holalluis/lora-waspmote/felix-llegir-sensors-2019/README.txt

Com programar la placa

Pels sensors DS18B20 Anar a File, Examples, General, Basic Sensors,
BS_05_Reading_temp_DS18B20

Com rebre dades de la placa al PC: Amb la funció USB.print que veuràs als
exemples podràs enviar dades al PC per depurar el codi.  IMPORTANT: quan obris
la terminal del Arduino que s’han clonat, el Waspmote, veuràs que pots triar la
velocitat del port. Has de triar la velocitat de 115200 bauds.
