holalluis/lora-waspmote/guia-instal.lacio.md

# GUIA INSTAL·LACIÓ
*Ordinador*
1. Connectar MÓDEM USB internet
2. Connectar Gateway 
3. Obrir waspmote
4. Comprovar que s'envien dades

*Prototip*
1. Comprovar connexions

         i. Cables
  
        ii. Soldadures
  
       iii. Plaques connectades
  
        iv. Bateria
  
2. Segellar caixa amb sica o silicona
3. Desplegar cables de tots els sensors
4. Instal·lar caixa, amb cinta perforada galvanitzada

*Sensors*
1. Mirar núm de sensor de temperatura i localització (A,S,D)
2. Instal·lar sensors de temperatura
3. Instal·lar sensor maxbotix
4. Mirar alçada làmina d'aigua Maxbotix
5. Instal·lar capacitiu
