holalluis/lora-waspmote/docs/Protocol de carrega de la bateria.pdf

### Protocol de càrrega de la bacteria del Waspmote

1. Endollar la bateria al connector que s’indica.

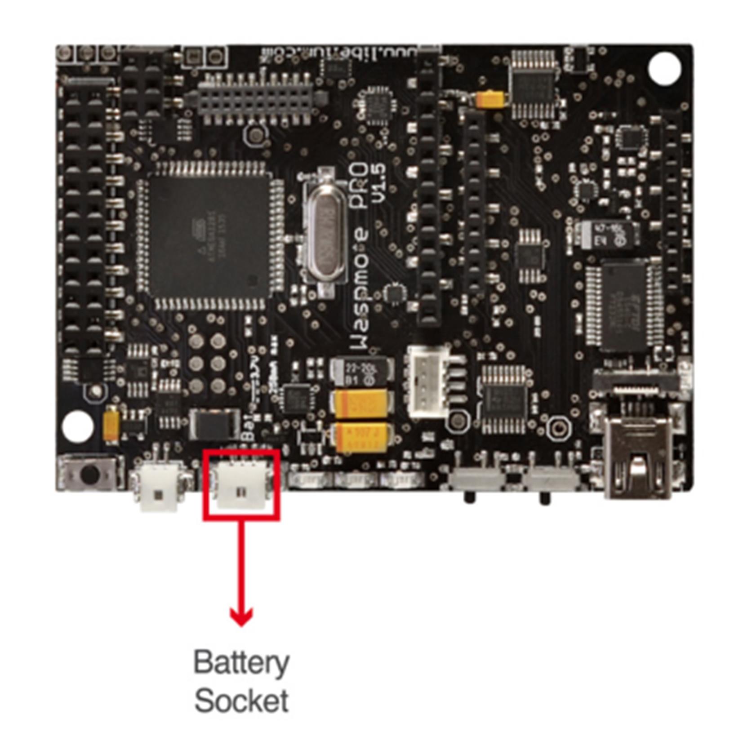
[picture p1: figure]

2. Endollar el cable miniusb a una font d’alimentació. Es recomana que sigui un portàtil o un carregador de mòbil.

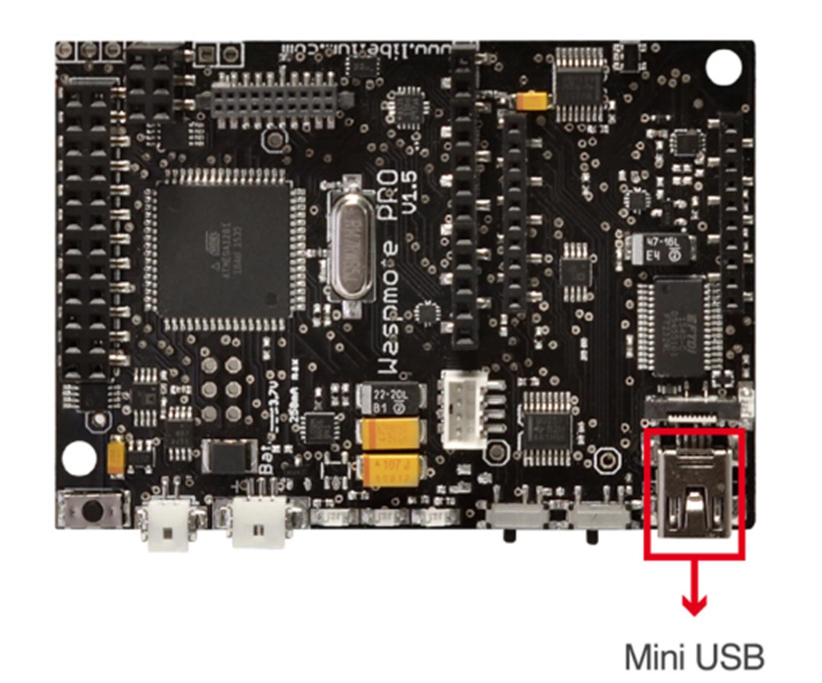
[picture p2: figure]
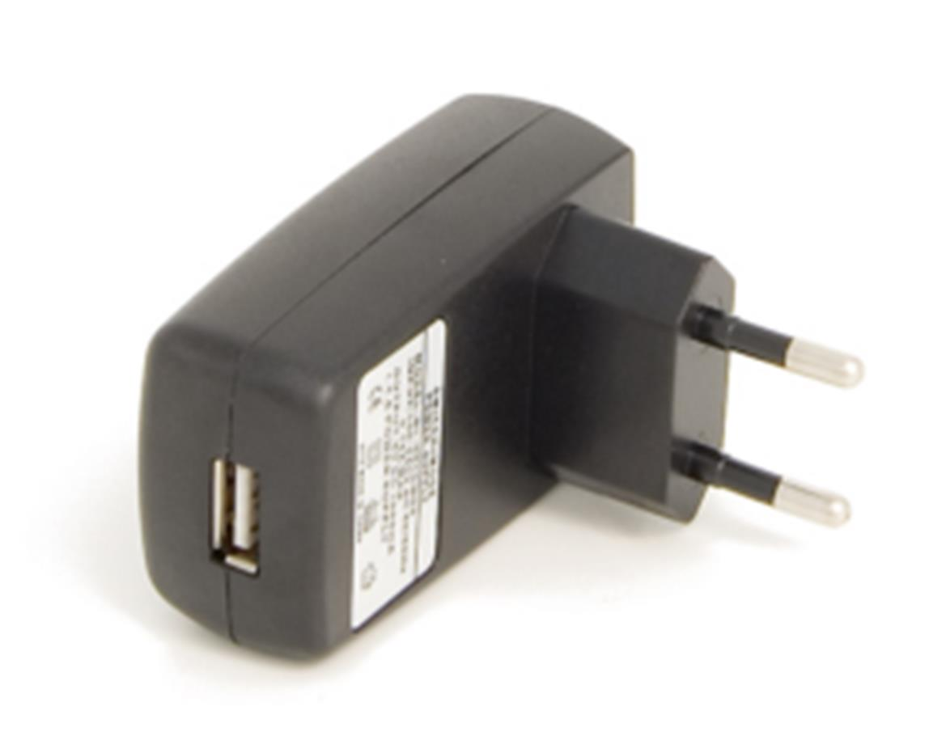
[picture p3: figure]

### 3. Quan la bateria s’estigui carregant s’engegarà el batery LED:

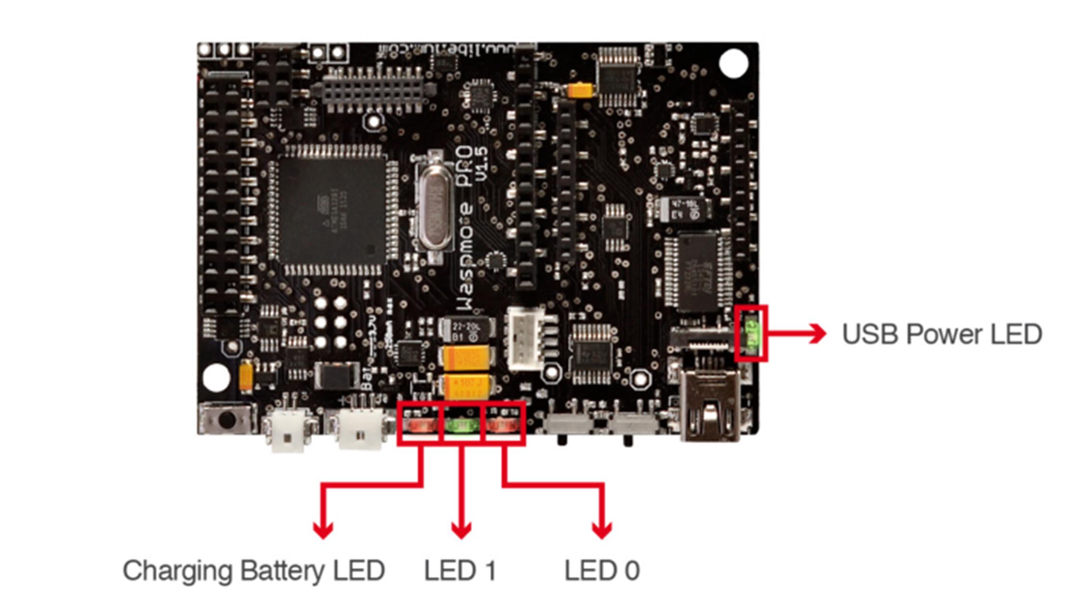
[picture p4: figure]

Un cop la bateria estigui completament carregada, el battery LED s’apagarà.
