holalluis/lora-waspmote/docs/waspmote_pins.png

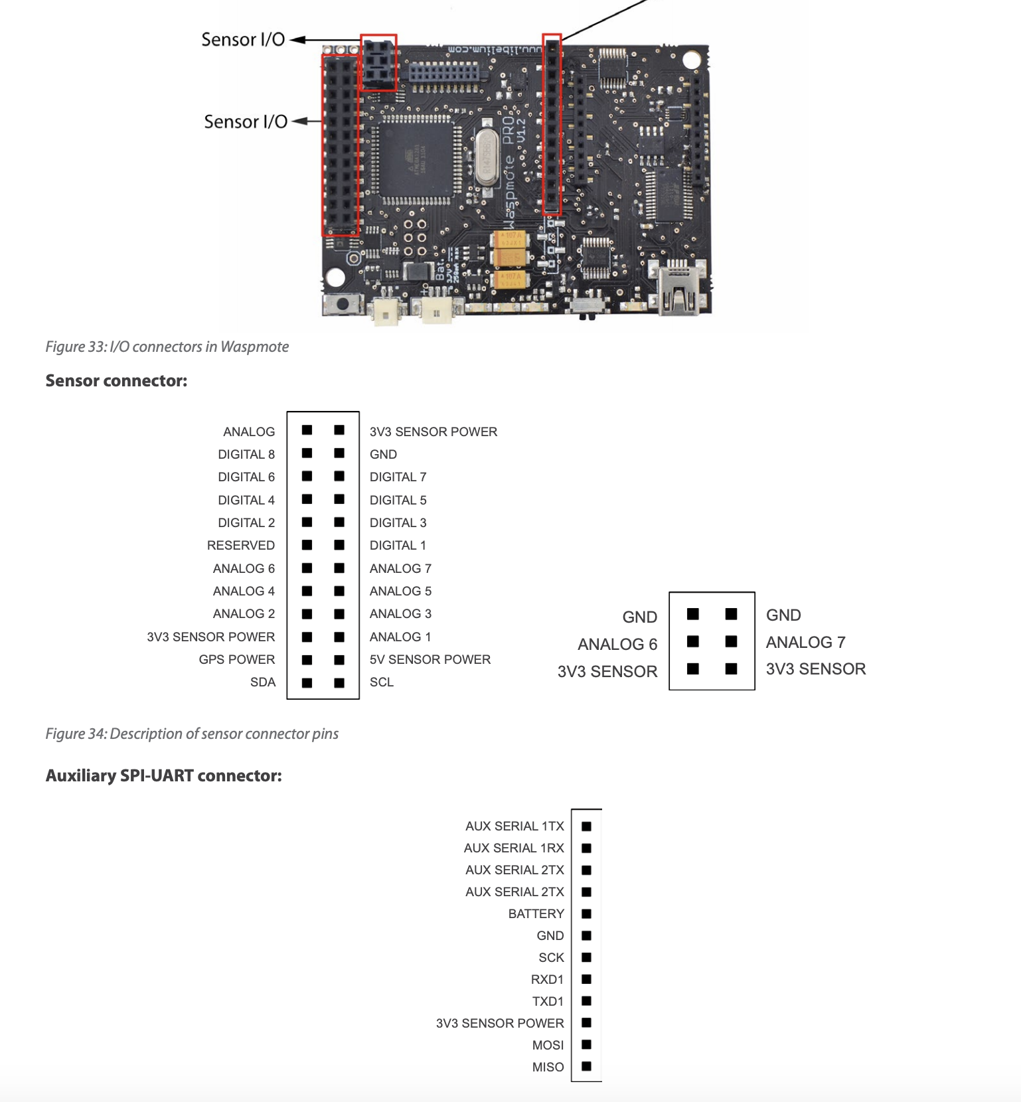
docs/waspmote_pins.png
