holalluis/lora-waspmote/docs/llistat_material.md

DESCRIPCIÓ                                    | EMPRESA             | REFERÈNCIA
--------------------------------------------------------------------------------

Material circuit imprès
-----------------------
```
Circuit imprès fabricat                       | 2CISA               | S'han d'enviar els fitxers de fabricacio
Tira pins connectors 2 columnes               | Mouser              | 200-SSQ10704LD
Tira pins connectors 1 columna                | Mouser              | SSW-106-04-F-S
Resistencies 4k7                              | Mouser              | CFR-25JT-52-4K7
Placa base libelium Waspmote                  | Libelium            |
Modul LoRa libelium                           | Libelium            |
```

Bateria
-------
```
6600mA·h Rechargeable Battery HSCODE:85076000 | Libelium | 6041W
Exemple                                       | Exemple  | Exemple
```

Caixa
-----
```
Caixa                                         | Dis-Electric        |
Bulguin USB                                   | Mouser              | PX0842/B
Tapa BulginUSB                                | Mouser              | PX0733
Cable USB del Bulgun a mini-usb               | Mouser              | SC-2AMK003F
Connector Bulgin caixa                        | Mouser              | PX0738/S
Connector Bulgin cable                        | Mouser              | PX0739/P
Premsastopas (max., tmp., ultraso)            | Dis-Electric        | Premsastopa de 10mm
Bulguin Atena                                 | Proveïdor Silvia    |
Cola "No mas clavos"                          | Ferreteria genèrica |
```

Sensors
-------
```
Maxbotix MB7369                               | Mouser              | MB7092
Femella Maxbotix                              | INFERSA             | 3/4”-14 NPS
Caixa per maxbotix                            | Diselectric         | Caixa de superficie de 40cm
Cable 4x0.5                                   | Diselectric         | 4x0.5
Microcom                                      | Microcom            |
Temperatura DS18D20 de 5 metres de llarg      | Amazon              | DS18B20 5m
```

Antena
------
```
Antena per LoRa                               |                     | Les del proveïdor que ja vau utilitzar
Pigtail per antena a LoRa Libelium            | Mouser              | CSI-SGFB-200-UFFR
```
