holalluis/lora-waspmote/docs/Planol Elèctric.pdf

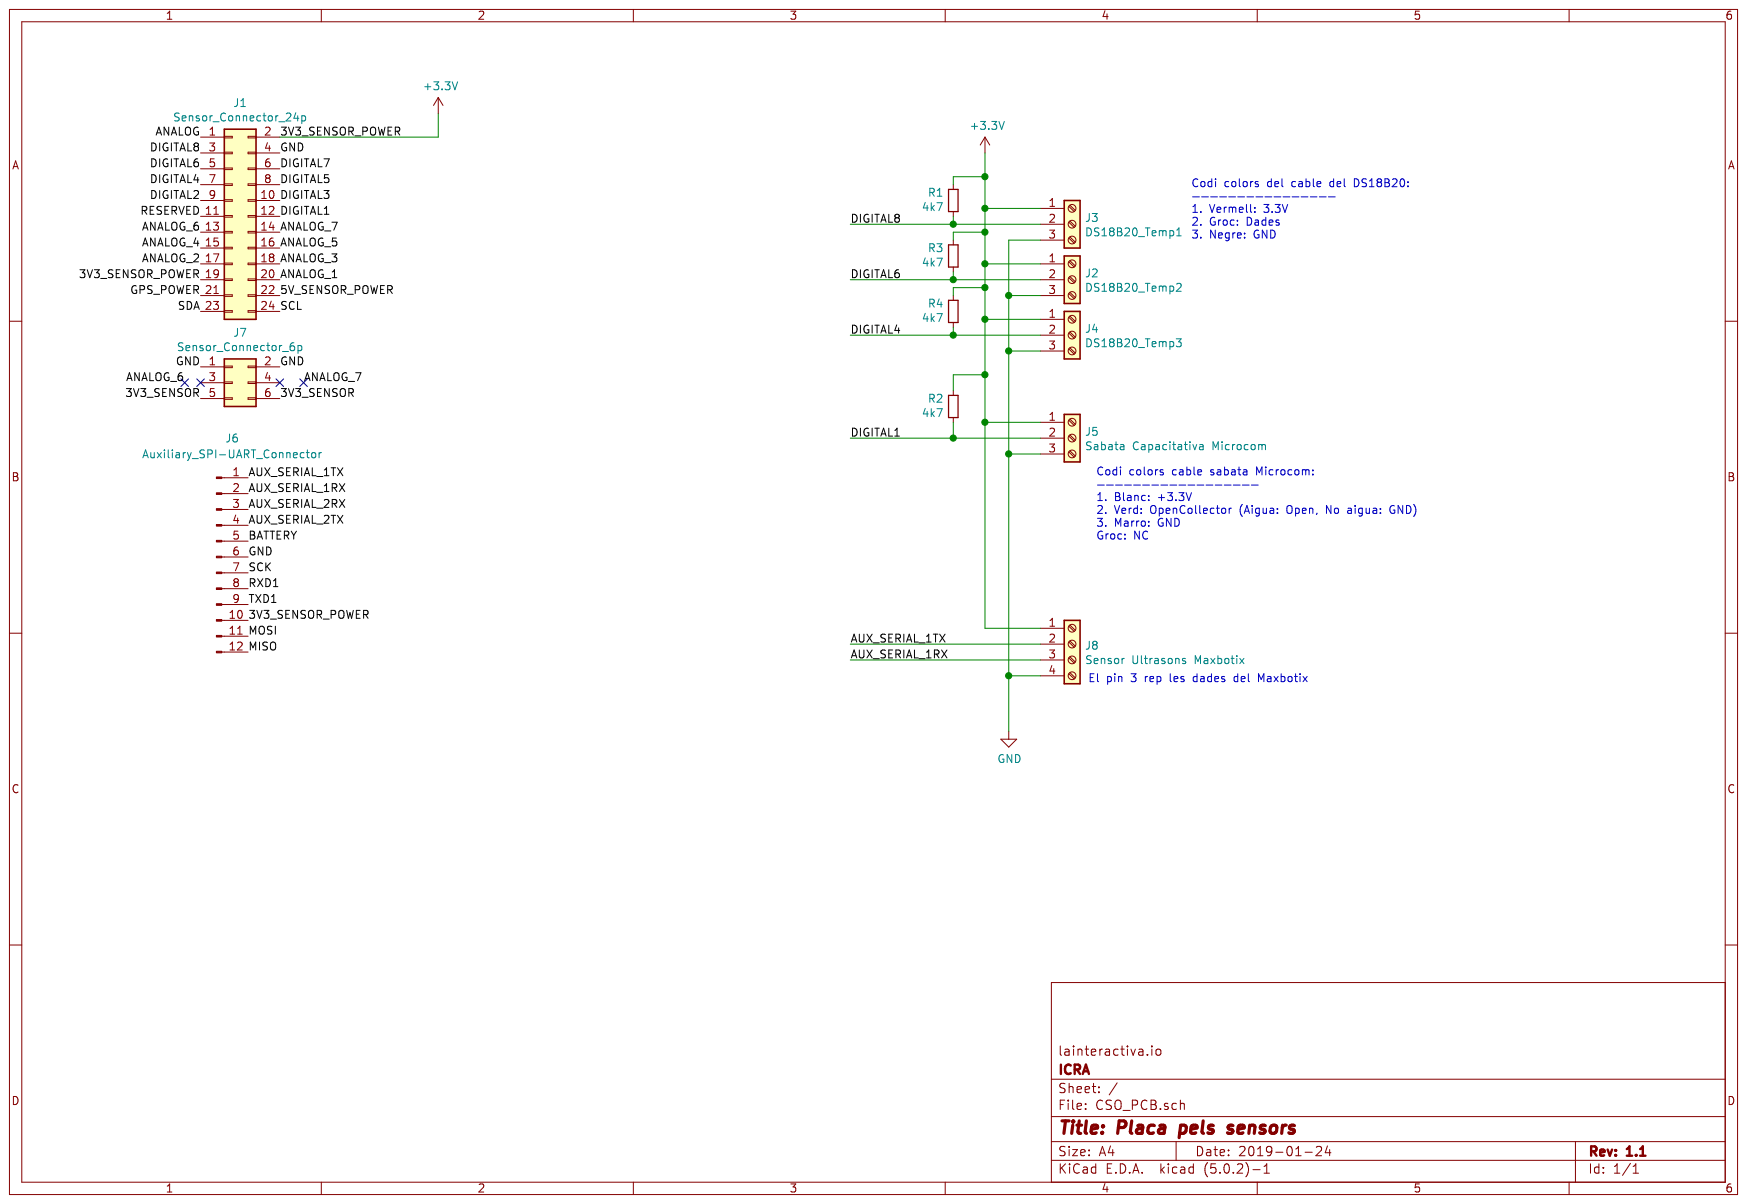
[picture p8: page 1]
