holalluis/lora-waspmote/TODO.txt

implementar threads al codi gateway per processar paquets rebuts

implementar canvi de potència dinàmic
