holalluis/lora-waspmote/(commit log)

2019-02-13 millorant el codi
2019-05-03 Create material_percomprar
